AxxAxx/AxxSolder_hw/3rd-parties-libraries/3D-models/STL10N3LLH5.stp

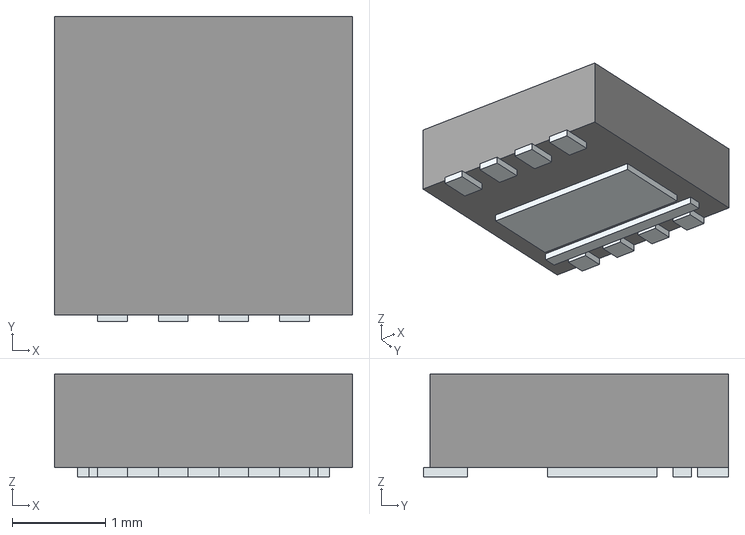
[picture p2: CAD file, 2023-12-22]
3rd-parties-libraries/3D-models/STL10N3LLH5.stp
3.20 x 3.27 x 1.10 mm
Pins
