AxxAxx/AxxSolder_hw/3rd-parties-libraries/3D-models/LM358BAIDR.stp

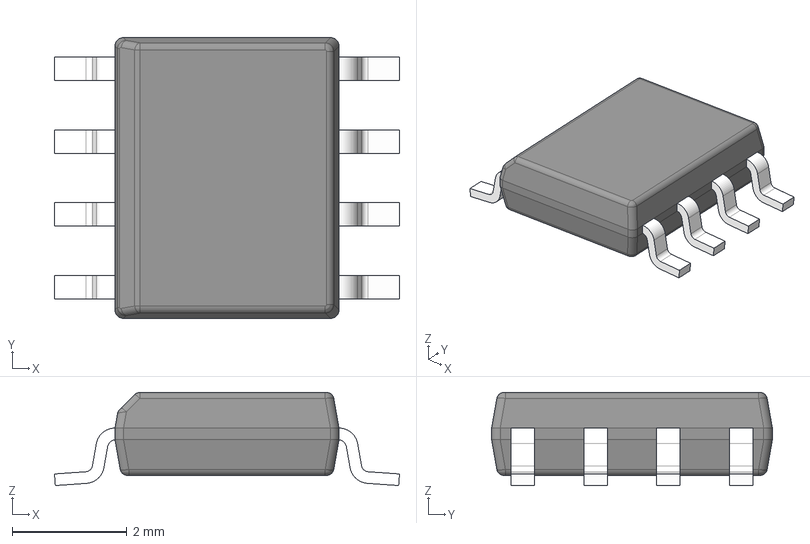
[picture p3: CAD file, 2023-12-22]
3rd-parties-libraries/3D-models/LM358BAIDR.stp
6.02 x 4.90 x 1.63 mm
BODY-SO
LEAD-D0008A x 8
