AxxAxx/AxxSolder_hw/3rd-parties-libraries/3D-models/PMEG10030ELPX.stp

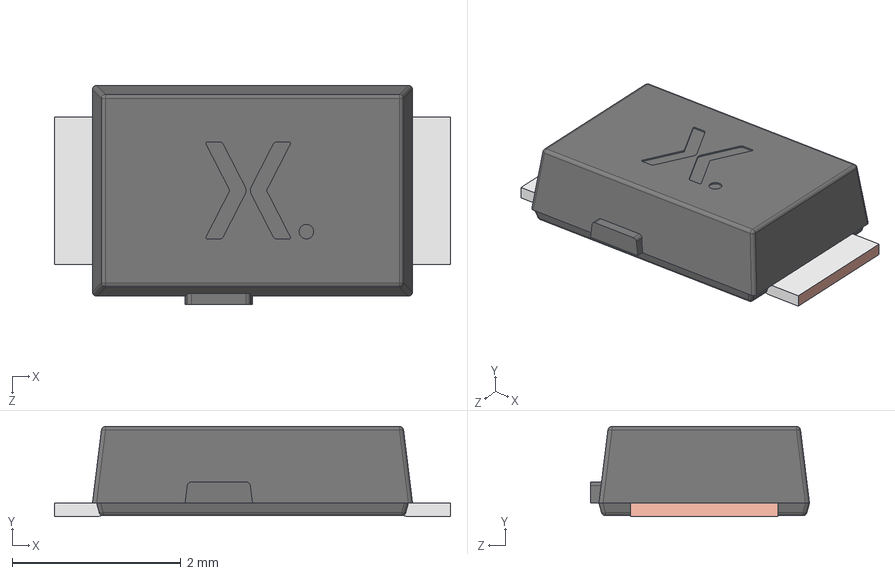
[picture p4: CAD file, 2023-12-22]
3rd-parties-libraries/3D-models/PMEG10030ELPX.stp
4.70 x 1.07 x 2.60 mm
SOD128 Lead
SOD128 Lower body
SOD128 Upper body
