AxxAxx/AxxSolder_hw/3rd-parties-libraries/3D-models/STM32G431KBT6.stp

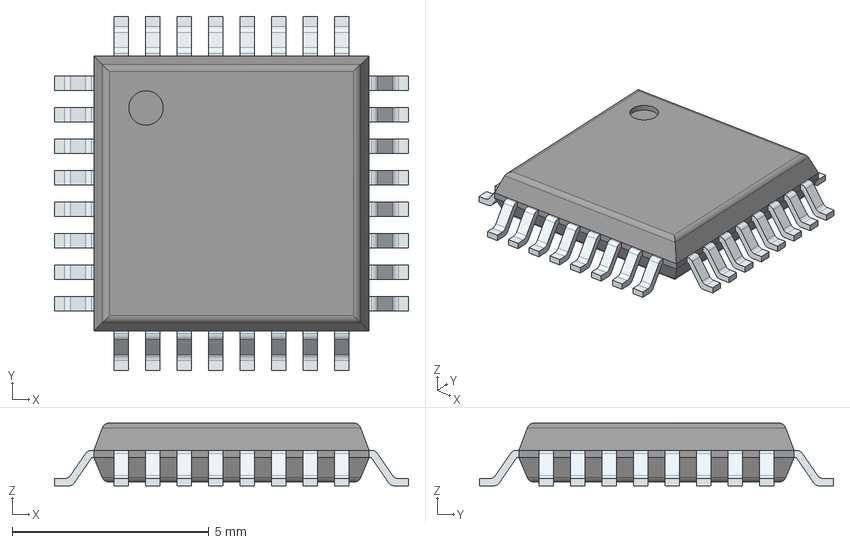
[picture p5: CAD file, 2023-12-22]
3rd-parties-libraries/3D-models/STM32G431KBT6.stp
9.00 x 9.00 x 1.60 mm
PinsArrayLR
PinsArrayTB
