AxxAxx/AxxSolder_hw/3rd-parties-libraries/3D-models/EMZR500ARA331MJA0G.stp

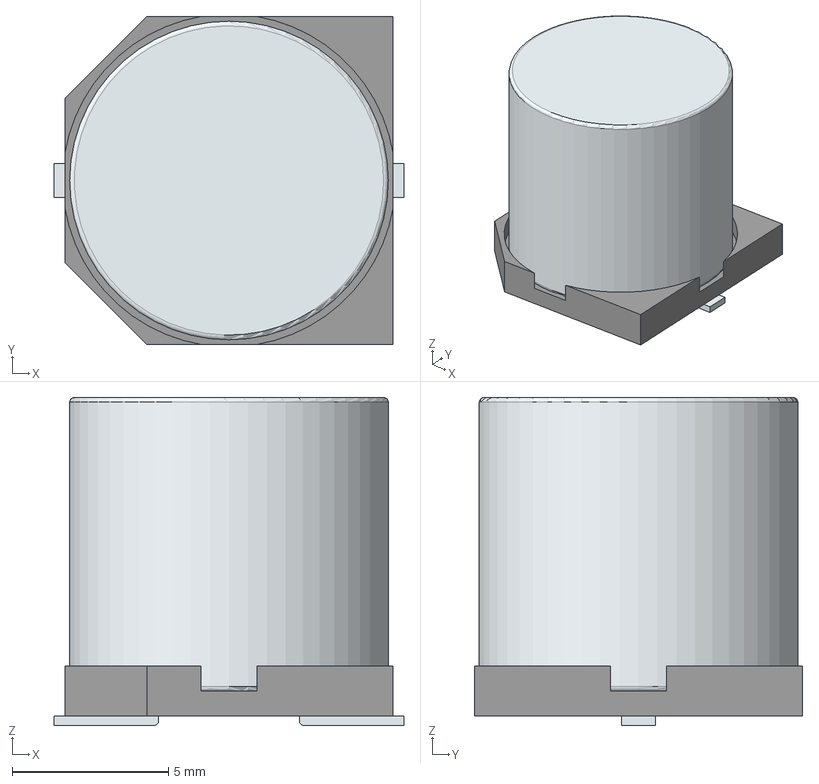
[picture p6: CAD file, 2023-12-22]
3rd-parties-libraries/3D-models/EMZR500ARA331MJA0G.stp
11.2 x 10.5 x 10.5 mm
Base
Pin1Fillet
Pin2Fillet
