AxxAxx/AxxSolder_hw/3rd-parties-libraries/3D-models/LD1117AS33TR.stp

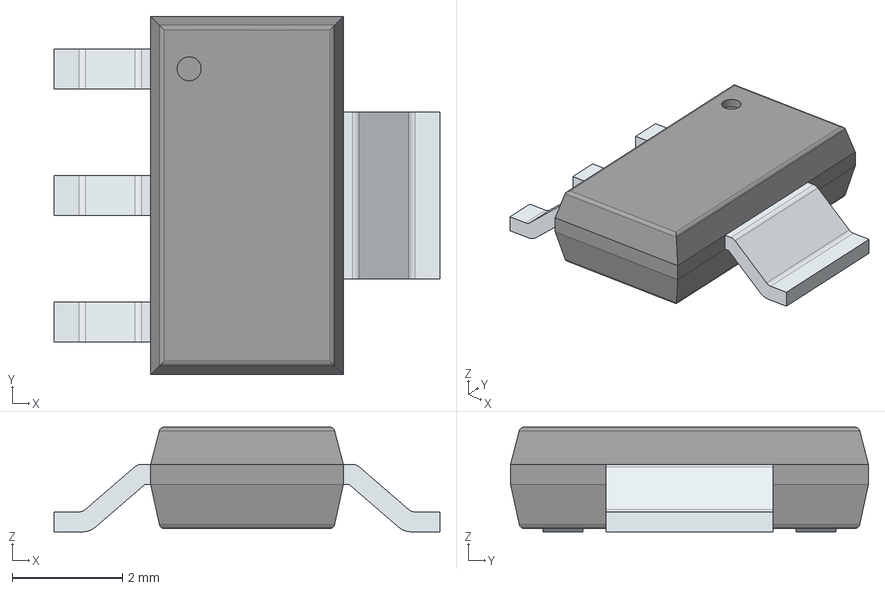
[picture p9: CAD file, 2023-12-22]
3rd-parties-libraries/3D-models/LD1117AS33TR.stp
7.00 x 6.50 x 1.90 mm
PinsArrayL
FilletPinR
