AxxAxx/AxxSolder_hw/3rd-parties-libraries/3D-models/CMI-9653S-SMT-TR.stp

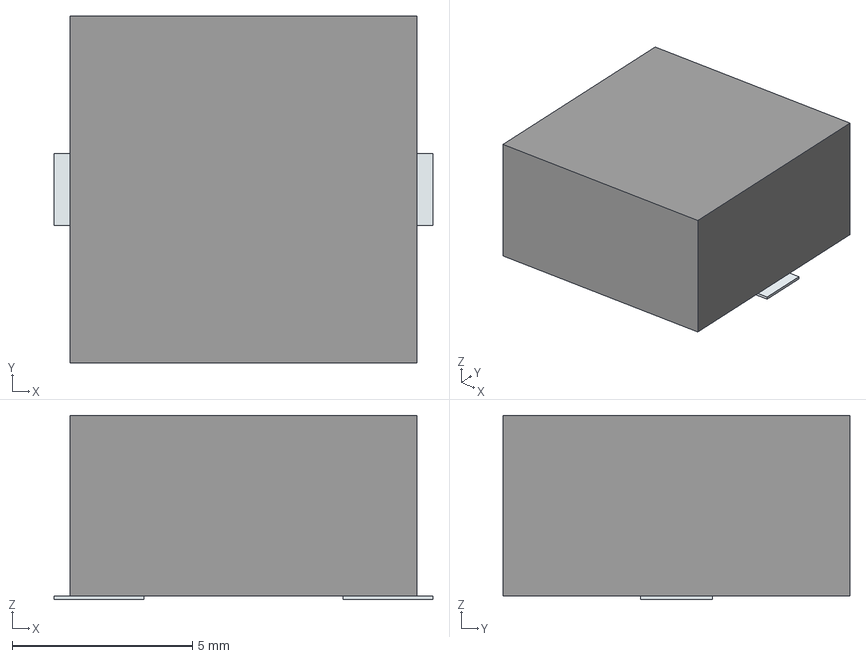
[picture p10: CAD file, 2023-12-22]
3rd-parties-libraries/3D-models/CMI-9653S-SMT-TR.stp
10.5 x 9.60 x 5.10 mm
Pins
