AxxAxx/AxxSolder_hw/3rd-parties-libraries/3D-models/STM32F303CCT6TR.stp

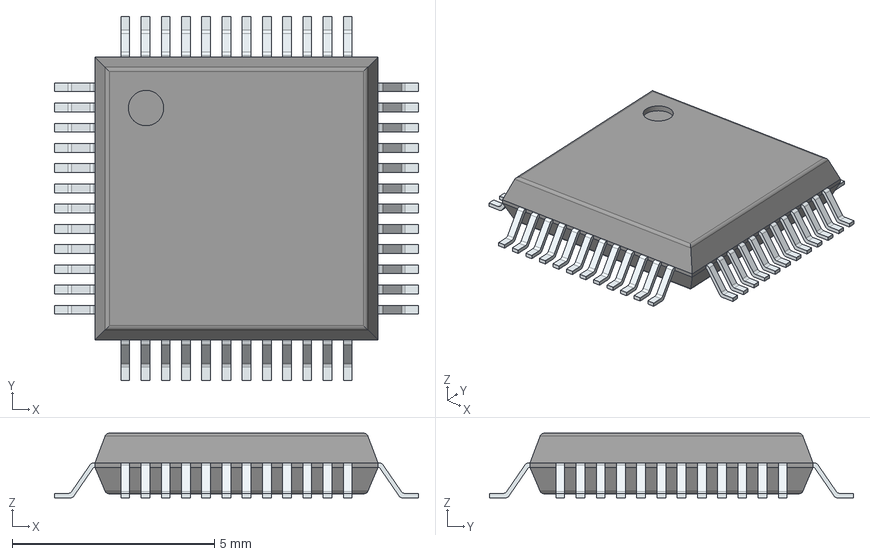
[picture p11: CAD file, 2023-12-22]
3rd-parties-libraries/3D-models/STM32F303CCT6TR.stp
9.00 x 9.00 x 1.60 mm
PinsArrayLR
PinsArrayTB
