AxxAxx/AxxSolder_hw/3rd-parties-libraries/3D-models/SRP7028CC-100M.stp

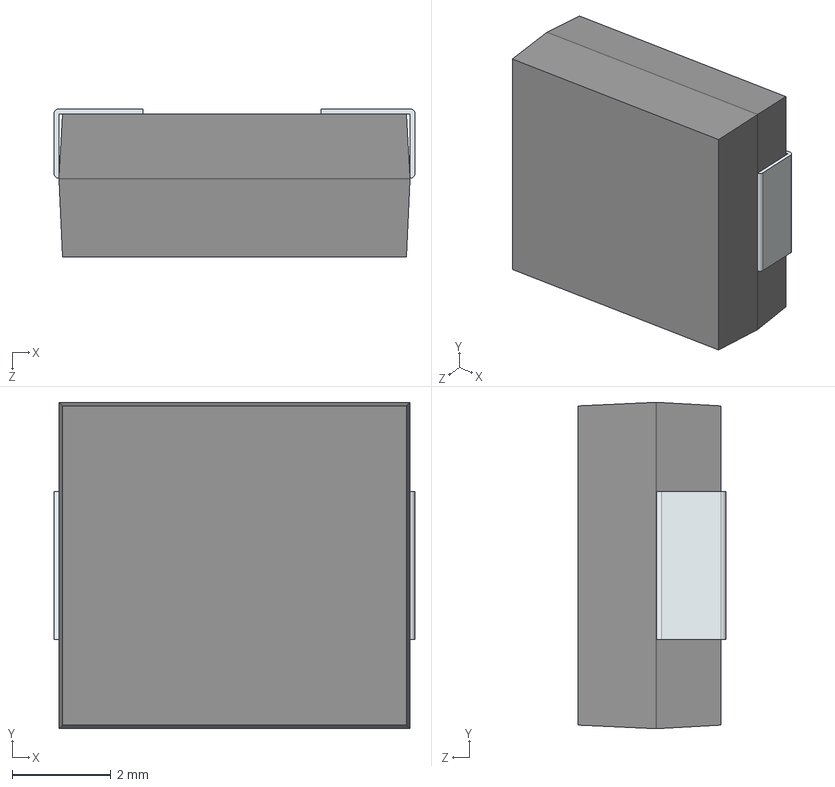
[picture p13: CAD file, 2023-12-22]
3rd-parties-libraries/3D-models/SRP7028CC-100M.stp
7.30 x 6.60 x 3.00 mm
Chamfer.stp
FilletPin1.stp
FilletPin2.stp
