AxxAxx/AxxSolder_hw/3rd-parties-libraries/3D-models/ADTSM6.STEP

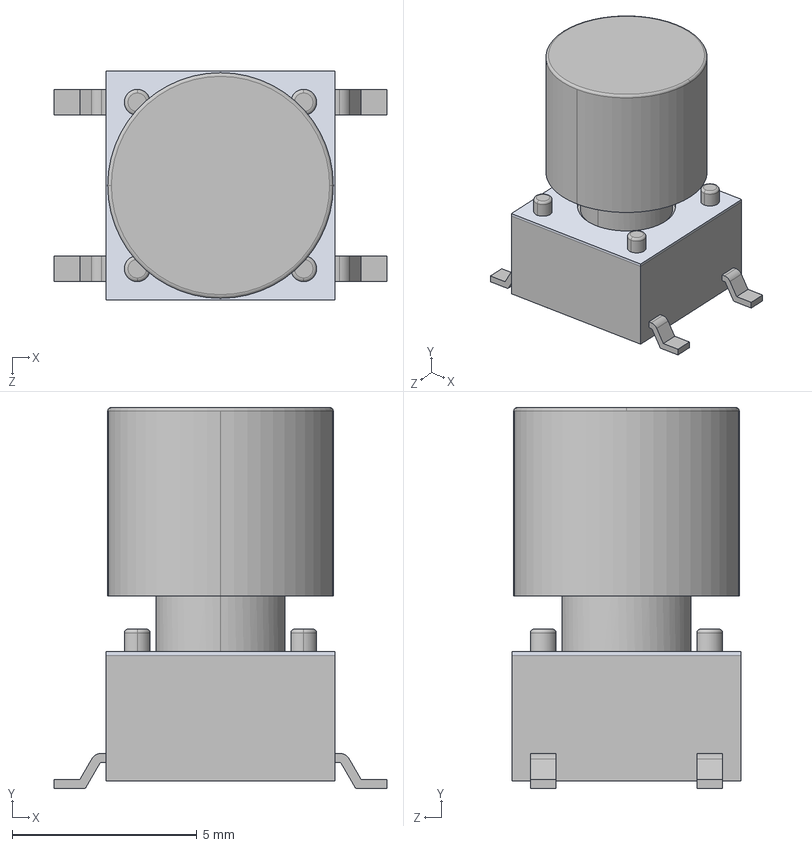
[picture p14: CAD file, 2023-12-22]
3rd-parties-libraries/3D-models/ADTSM6.STEP
9.00 x 10.3 x 6.20 mm
