AxxAxx/AxxSolder_hw/3rd-parties-libraries/3D-models/USB4110-GF-A.stp

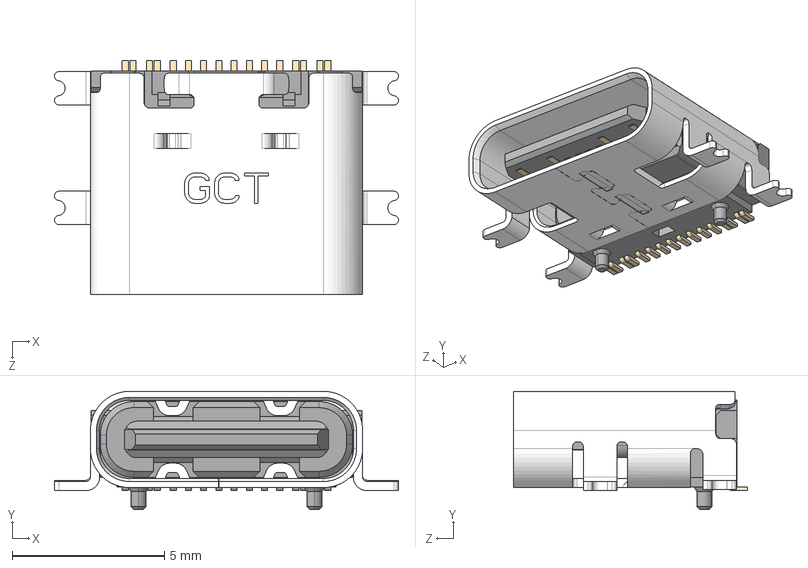
[picture p15: CAD file, 2023-12-22]
3rd-parties-libraries/3D-models/USB4110-GF-A.stp
11.3 x 3.89 x 7.70 mm
