AxxAxx/AxxSolder_hw/3rd-parties-libraries/3D-models/SMBJ24A.stp

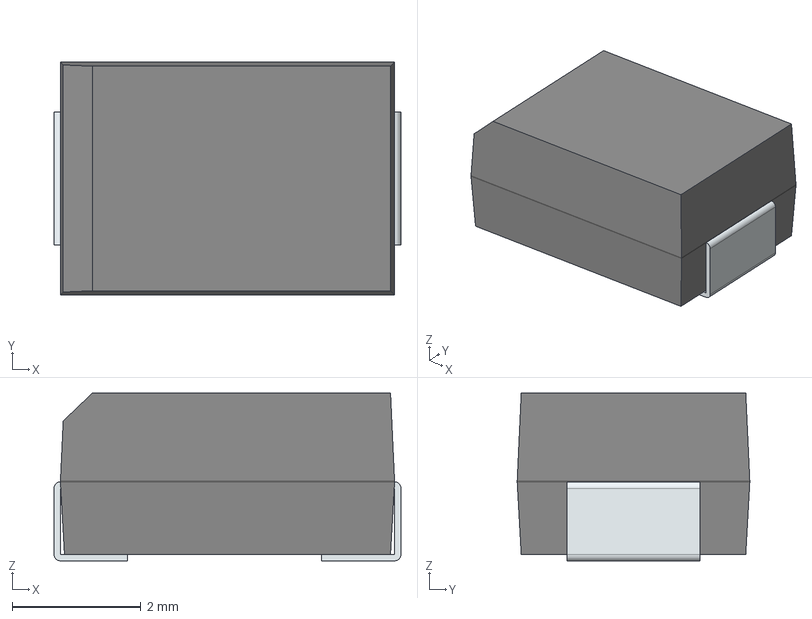
[picture p16: CAD file, 2023-12-07]
3rd-parties-libraries/3D-models/SMBJ24A.stp
5.40 x 3.62 x 2.61 mm
FilletPin1
FilletPin2
