AxxAxx/AxxSolder_hw/3rd-parties-libraries/3D-models/ESDA25P35-1U1M.stp

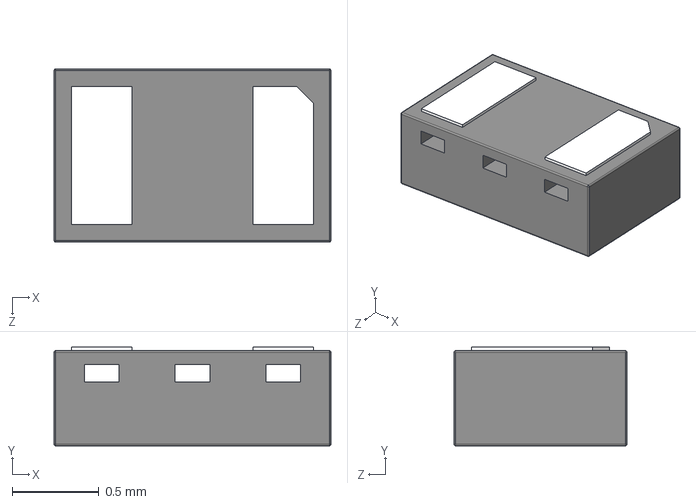
[picture p17: CAD file, 2023-12-07]
3rd-parties-libraries/3D-models/ESDA25P35-1U1M.stp
1.60 x 0.57 x 1.00 mm
