AxxAxx/AxxSolder_hw/3rd-parties-libraries/3D-models/LTC4440AHMS8E-5#PBF.stp

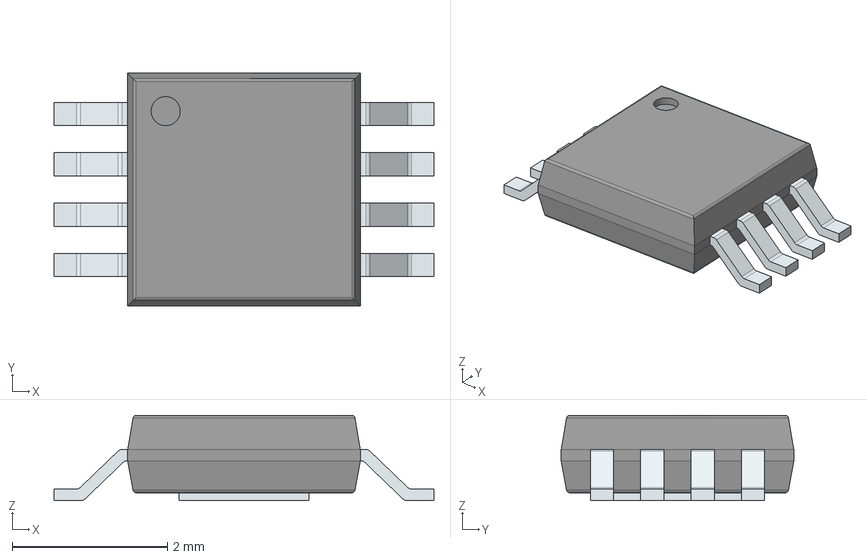
[picture p18: CAD file, 2023-12-07]
3rd-parties-libraries/3D-models/LTC4440AHMS8E-5#PBF.stp
4.90 x 3.00 x 1.10 mm
PinsArrayLR
ThermalPad
