AxxAxx/AxxSolder_hw/3rd-parties-libraries/3D-models/OPA2387DSGT.stp

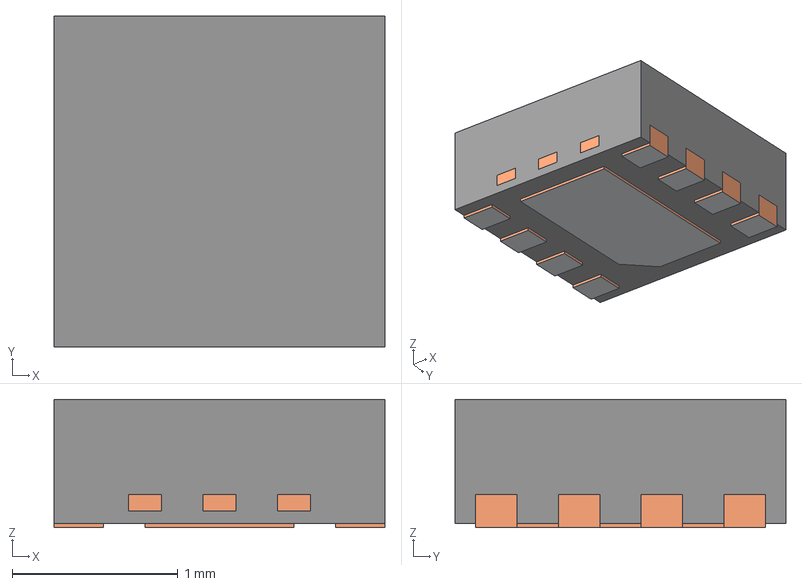
[picture p22: CAD file, 2023-12-07]
3rd-parties-libraries/3D-models/OPA2387DSGT.stp
2.00 x 2.00 x 0.775 mm
BODY-SON
FRAME-DSG0008A
PIN1-ID
