AxxAxx/AxxSolder_hw/3rd-parties-libraries/3D-models/STL9P3LLH6.stp

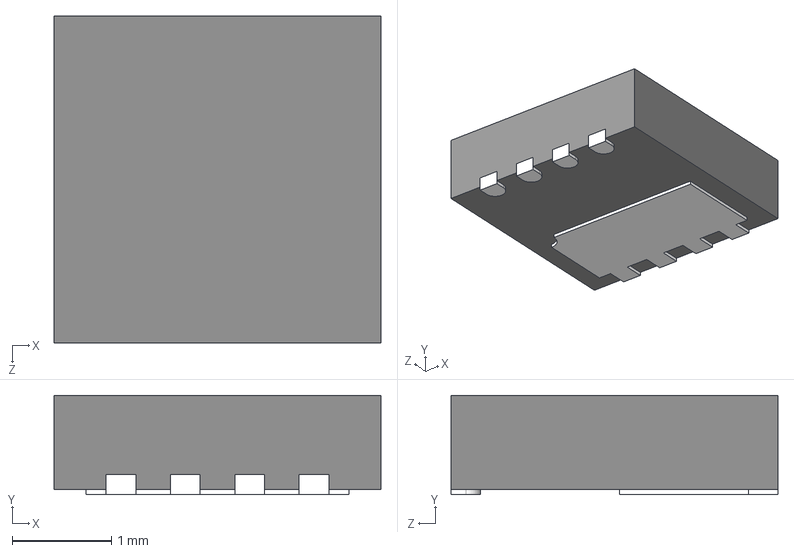
[picture p23: CAD file, 2023-12-07]
3rd-parties-libraries/3D-models/STL9P3LLH6.stp
3.30 x 1 x 3.30 mm
