AxxAxx/AxxSolder_hw/3rd-parties-libraries/3D-models/BLM18HE601SN1D.stp

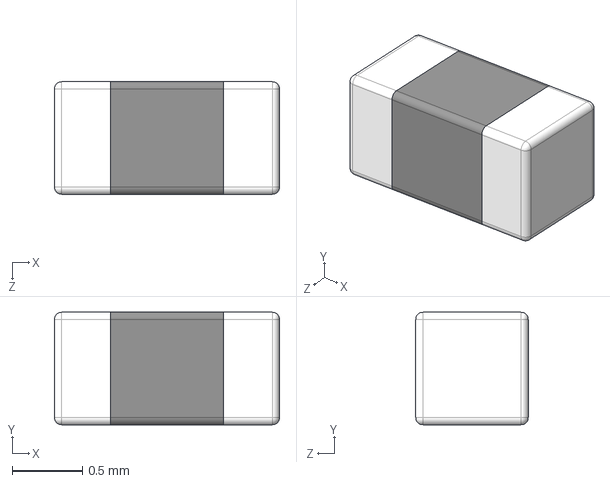
[picture p24: CAD file, 2023-12-07]
3rd-parties-libraries/3D-models/BLM18HE601SN1D.stp
1.60 x 0.8 x 0.8 mm
