AxxAxx/AxxSolder_hw/3rd-parties-libraries/3D-models/ESDA25W.stp

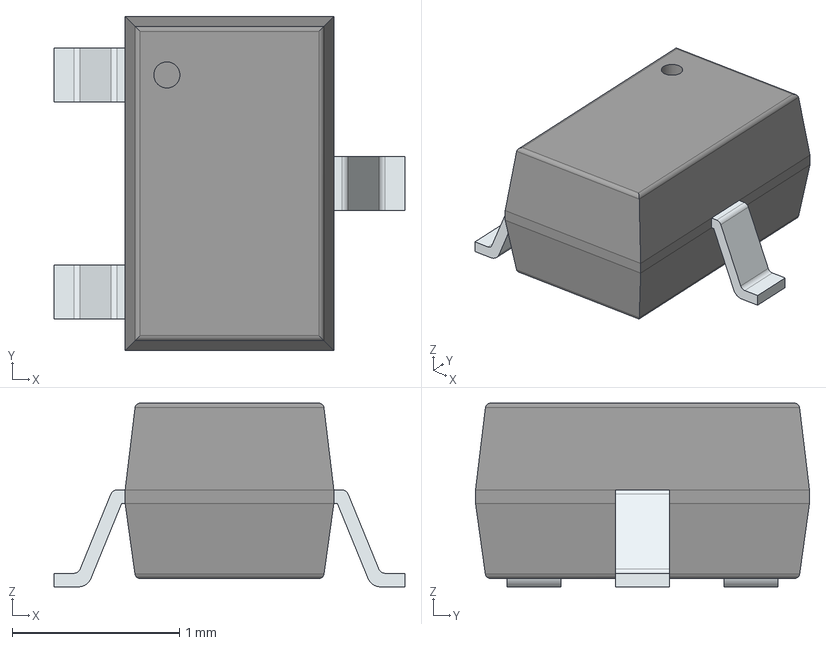
[picture p25: CAD file, 2023-12-07]
3rd-parties-libraries/3D-models/ESDA25W.stp
2.10 x 2.00 x 1.10 mm
PinsArrayL
FilletPinR
