AxxAxx/AxxSolder_hw/3rd-parties-libraries/3D-models/WSLP25125L000FEA.stp

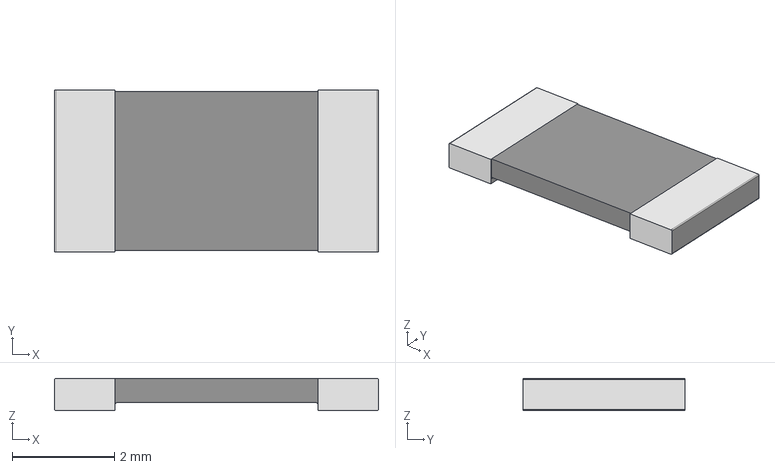
[picture p26: CAD file, 2023-12-07]
3rd-parties-libraries/3D-models/WSLP25125L000FEA.stp
6.35 x 3.18 x 0.635 mm
