AxxAxx/AxxSolder_hw/(list of files, cad)

Other CAD files:
3rd-parties-libraries/3D-models/0154007.DRTL.stp
3rd-parties-libraries/3D-models/691243110008.stp
3rd-parties-libraries/3D-models/691243110009.stp
3rd-parties-libraries/3D-models/ADTSM6.stp
3rd-parties-libraries/3D-models/LM74670QDGKRQ1.stp
3rd-parties-libraries/3D-models/MAX16171ATA_VY+T.stp
3rd-parties-libraries/3D-models/TPS54302DDCR.stp
