AxxAxx/AxxSolder_hw/AxxSolder.kicad_pcb

## KiCad design AxxSolder.kicad_pcb (2023-12-22)

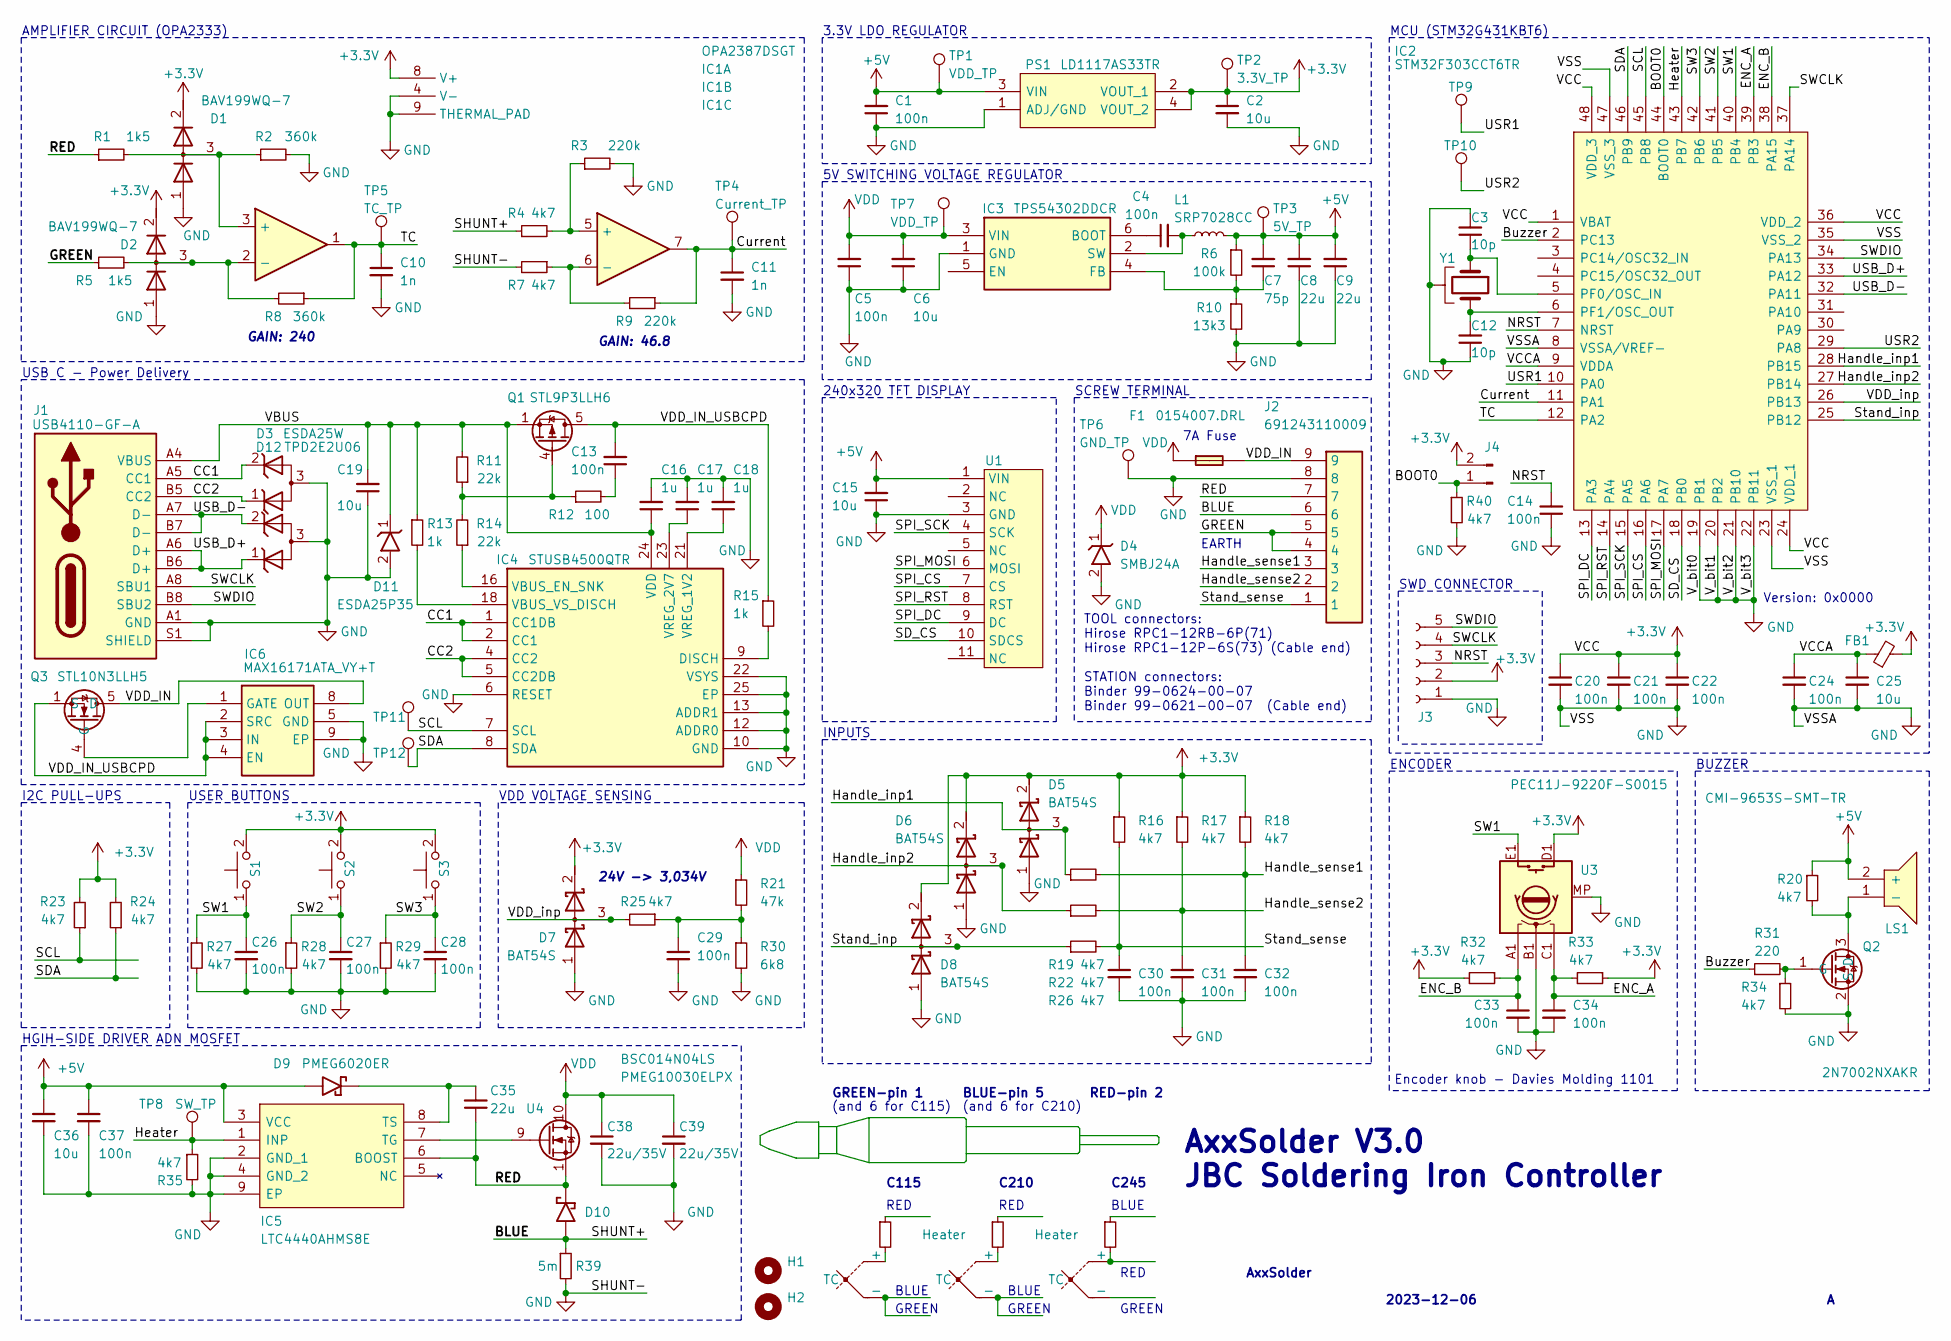
[picture p27: schematic AxxSolder.kicad_sch]

Parts:
C1, C4, C5, C13, C14, C20, C21, C22, C24, C26, C27, C28, C29, C30, C31, C32, C33, C34, C37: 100n; C_0603_1608Metric; Manufacturer_Part_Number GRM21BR72A104KAC4L
C2, C6, C15, C19, C25, C36: 10u; C_0603_1608Metric; Manufacturer_Part_Number GRM21BR6YA106ME43L
C3, C12: 10p; C_0603_1608Metric; Manufacturer_Part_Number GRM21A5C2E750FW01D
C7: 75p; C_0603_1608Metric; Manufacturer_Part_Number GRM21A5C2E750FW01D
C8, C9, C35: 22u; C_1206_3216Metric; Manufacturer_Part_Number C2012X6S1C226M125AC
C10, C11: 1n; C_0603_1608Metric; Manufacturer_Part_Number GRM2165C1H102JA01D
C16, C17, C18: 1u; C_0603_1608Metric; Manufacturer_Part_Number GRM21BC72A105KE01L
C38, C39: 22u/35V; C_1206_3216Metric; Manufacturer_Part_Number C3216X5R1V226M160AC
D1, D2: BAV199WQ-7; SOT65P210X110-3N; Mouser Part Number 621-BAV199WQ-7
D3: ESDA25W; SOT65P210X110-3N; Mouser Part Number 511-ESDA25W
D4: SMBJ24A; DIOM5436X261N; Mouser Part Number 576-SMBJ24A
D5, D6, D7, D8: BAT54S; SOT95P230X110-3N; Manufacturer_Part_Number BAT54S
D9: PMEG6020ER; PMEG6020ER115; Mouser Part Number 771-PMEG6020ER-115
D10: PMEG10030ELPX; SODFL4725X110N; Mouser Part Number 771-PMEG10030ELPX
D11: ESDA25P35; ESDA25P351U1M; Mouser Part Number 511-ESDA25P35-1U1M
D12: TPD2E2U06; SOT95P237X95-3N; Mouser Part Number 595-TPD2E2U06QDBZRQ1
F1: 0154007.DRL; 0154100DR; Mouser Part Number 576-0154007.DRL
FB1: BLM18HE601SN1D; R_0603_1608Metric; Mouser Part Number 81-BLM18HE601SN1D
H1, H2: MountingHole; MountingHole_2.5mm
IC1: OPA2387DSGT; SON50P200X200X80-9N; Mouser Part Number 595-OPA2387DSGT
IC2: STM32F303CCT6TR; QFP50P900X900X160-48N; Mouser Part Number 511-STM32F303CCT6TR
IC3: TPS54302DDCR; SOT95P280X110-6N; Mouser Part Number 595-TPS54302DDCR
IC4: STUSB4500QTR; QFN50P400X400X100-25N-D; Mouser Part Number 511-STUSB4500QTR
IC5: LTC4440AHMS8E; SOP65P490X110-9N; Mouser Part Number 584-C4440AHMS8E-5PBF
IC6: MAX16171ATA_VY+T; SON50P300X200X80-9N; Mouser Part Number 700-MAX16171ATA/VY+T
J1: USB4110-GF-A; USB4110GFA; Mouser Part Number 640-USB4110-GF-A
J2: 691243110009; Mouser Part Number 710-691243110009
J3: Conn_01x05_Socket; PinSocket_1x05_P2.54mm_Vertical
J4: Conn_01x02_Pin; PinHeader_1x02_P1.27mm_Vertical
L1: SRP7028CC; INDPM7366X300N; Mouser Part Number e
LS1: CMI-9653S-SMT-TR; CMI9653SSMTTR; Mouser Part Number 490-CMI-9653S-SMT-TR
PS1: LD1117AS33TR; SOT230P700X190-4N; Mouser Part Number 511-LD1117AS33
Q1: STL9P3LLH6; STL20N6F7; Mouser Part Number 511-STL9P3LLH6
Q2: 2N7002NXAKR; SOT95P230X110-3N; Manufacturer_Part_Number 2N7002NXAKR; Mouser Part Number 771-2N7002NXAKR
Q3: STL10N3LLH5; Mouser Part Number 511-STL10N3LLH5
R1, R5: 1k5; R_0603_1608Metric; Manufacturer_Part_Number ERJ-6ENF1501V
R2, R8: 360k; R_0603_1608Metric; Manufacturer_Part_Number ERJ-6ENF4703V
R3, R9: 220k; R_0603_1608Metric; Manufacturer_Part_Number ERJ-6ENF2203V
R4, R7, R19, R20, R22, R23, R24, R25, R26: 4k7; R_0603_1608Metric; Manufacturer_Part_Number ERJ-6ENF4701V
R6: 100k; R_0603_1608Metric; Manufacturer_Part_Number ERJ-6ENF1003V
R10: 13k3; R_0603_1608Metric; Manufacturer_Part_Number ERJ-6ENF1332V
R11, R14: 22k; R_0603_1608Metric; Manufacturer_Part_Number ERJ-6ENF2202V
R12: 100; R_0603_1608Metric; Manufacturer_Part_Number ERJ-6ENF1003V
R13: 1k; R_0603_1608Metric; Manufacturer_Part_Number ERJ-6ENF2202V
R15: 1k; R_0603_1608Metric; Manufacturer_Part_Number ERJ-6ENF1001V
R16, R17, R18, R27, R28, R29, R32, R33, R34, R35, R40: 4k7; R_0603_1608Metric; Manufacturer_Part_Number ERJ-6ENF1002V
R21: 47k; R_0603_1608Metric; Manufacturer_Part_Number ERJ-6ENF4702V
R30: 6k8; R_0603_1608Metric; Manufacturer_Part_Number ERJ-6ENF6801V
R31: 220; R_0603_1608Metric; Manufacturer_Part_Number ERJ-6ENF2200V
R36, R37: Heater
R38: Heater 2 OHM
R39: 5m; RESC6432X89N; Mouser Part Number 71-WSLP25125L000FEA
S1, S2, S3: ADTSM644KVTR; Mouser Part Number 642-ADTSM644KVTR
TC1, TC2, TC3: TC
TP1, TP7: VDD_TP; TestPoint_THTPad_D1.0mm_Drill0.5mm
TP2: 3.3V_TP; TestPoint_THTPad_D1.0mm_Drill0.5mm
TP3: 5V_TP; TestPoint_THTPad_D1.0mm_Drill0.5mm
TP4: Current_TP; TestPoint_Pad_D1.0mm
TP5: TC_TP; TestPoint_Pad_D1.0mm
TP6: GND_TP; TestPoint_THTPad_D1.0mm_Drill0.5mm
TP8: SW_TP; TestPoint_Pad_D1.0mm
TP9, TP10, TP11, TP12: DIAG_TP; TestPoint_Pad_D1.0mm
U1: Adafruit_240x320_TFT
U3: PEC11J-9220F-S0015; PEC11J9220FS0015; Mouser Part Number 652-PEC11J9220FS0015
U4: BSC014N04LS; Manufacturer_Part_Number BSC014N04LSATMA1
Y1: NX2016SA-32M-EXS00A-CS06465; NX2016SA32MEXS00ACS06465; Mouser Part Number 344-NX2016SA32S06465

Connections:
+3.3V: C2.1, C20.1, C21.1, C22.1, D1.2, D2.2, D5.2 (K), D6.2 (K), D7.2 (K), D8.2 (K), FB1.2, IC1.8 (V+), IC2.1 (VBAT), IC2.24 (VDD_1), IC2.36 (VDD_2), IC2.48 (VDD_3), J3.2, J4.2, PS1.2 (VOUT_1), PS1.4 (VOUT_2), R16.1, R17.1, R18.1, R23.2, R24.2, R32.2, R33.1, S1.2, S2.2, S3.2, TP2.1, U3.D1
+5V: C1.2, C7.2, C8.2, C9.2, C15.2, C36.1, C37.1, D9.2, IC5.3 (VCC), L1.2, LS1.2 (+), PS1.3 (VIN), R6.1, R20.1, TP1.1, TP3.1, U1.1 (VIN)
/BLUE: D10.2, J2.6, R4.1, R39.1
/BOOT0: IC2.44 (BOOT0), J4.1, R40.1
/Buzzer: IC2.2 (PC13), R31.1
/CC1: D3.2, IC4.1 (CC1DB), IC4.2 (CC1), J1.A5 (CC1)
/CC2: D3.1, IC4.4 (CC2), IC4.5 (CC2DB), J1.B5 (CC2)
/Current: C11.1, IC1.7, IC2.11 (PA1), R9.1, TP4.1
/ENC_A: C34.1, IC2.39 (PB3), R33.2, U3.C1
/ENC_B: C33.1, IC2.38 (PA15), R32.1, U3.A1
/GREEN: J2.4, J2.5, R5.1
/Handle_inp1: D5.3 (common), IC2.28 (PB15), R19.1
/Handle_inp2: D6.3 (common), IC2.27 (PB14), R22.1
/Handle_sense1: C32.1, J2.3, R18.2, R19.2
/Handle_sense2: C31.1, J2.2, R17.2, R22.2
/Heater: IC2.43 (PB7), IC5.1 (INP), R35.1, TP8.1
/NRST: C14.2, IC2.7 (NRST), J3.3
/RED: C35.1, D10.1, IC5.6 (BOOST), J2.7, R1.1, U4.1 (S)
/SCL: IC2.45 (PB8), IC4.7 (SCL), R23.1, TP11.1
/SDA: IC2.46 (PB9), IC4.8 (SDA), R24.1, TP12.1
/SD_CS: IC2.18 (PB0), U1.10 (SDCS)
/SPI_CS: IC2.16 (PA6), U1.7 (CS)
/SPI_DC: IC2.13 (PA3), U1.9 (DC)
/SPI_MOSI: IC2.17 (PA7), U1.6 (MOSI)
/SPI_RST: IC2.14 (PA4), U1.8 (RST)
/SPI_SCK: IC2.15 (PA5), U1.4 (SCK)
/SW1: C26.1, IC2.40 (PB4), R27.1, S1.1, U3.E1
/SW2: C27.1, IC2.41 (PB5), R28.1, S2.1
/SW3: C28.1, IC2.42 (PB6), R29.1, S3.1
/SWCLK: IC2.37 (PA14), J1.A8 (SBU1), J3.4
/SWDIO: IC2.34 (PA13), J1.B8 (SBU2), J3.5
/Stand_inp: D8.3 (common), IC2.25 (PB12), R26.1
/Stand_sense: C30.1, J2.1, R16.2, R26.2
/TC: C10.1, IC1.1, IC2.12 (PA2), R8.1, TP5.1
/USB_D+: D12.1, IC2.33 (PA12), J1.A6 (D+), J1.B6 (D+)
/USB_D-: D12.2, IC2.32 (PA11), J1.A7 (D-), J1.B7 (D-)
/USR1: IC2.10 (PA0), TP9.1
/USR2: IC2.29 (PA8), TP10.1
/VBUS: C16.1, C19.2, D11.1 (K), IC4.24 (VDD), J1.A4 (VBUS), J1.A9 (VBUS), J1.B4 (VBUS), J1.B9 (VBUS), Q1.1 (S), R11.2, R13.1
/VCCA: C24.1, C25.1, FB1.1, IC2.9 (VDDA)
/VDD_IN: F1.2, IC6.8 (OUT), J2.9, Q3.5 (D)
/VDD_IN_USBCPD: C13.2, IC6.2 (SRC), IC6.3 (IN), IC6.4 (EN), Q1.5 (D), Q3.1 (S), R15.1
/VDD_inp: D7.3 (common), IC2.26 (PB13), R25.2
GND: C1.1, C2.2, C3.2, C5.1, C6.1, C8.1, C9.1, C10.2, C11.2, C12.1, C14.1, C15.1, C16.2, C17.2, C18.2, C19.1, C20.2, C21.2, C22.2, C24.2, C25.2, C26.2, C27.2, C28.2, C29.2, C30.2, C31.2, C32.2, C33.2, C34.2, C36.2, C37.2, C38.2, C39.2, D1.1, D2.1, D3.3, D4.2 (A), D5.1 (A), D6.1 (A), D7.1 (A), D8.1 (A), D11.2 (A), D12.3, IC1.4 (V-), IC1.9 (THERMAL_PAD), IC2.8 (VSSA/VREF-), IC2.19 (PB1), IC2.20 (PB2), IC2.21 (PB10), IC2.22 (PB11), IC2.23 (VSS_1), IC2.35 (VSS_2), IC2.47 (VSS_3), IC3.1 (GND), IC4.6 (RESET), IC4.10 (GND), IC4.12 (ADDR0), IC4.13 (ADDR1), IC4.22 (VSYS), IC4.25 (EP), IC5.2 (GND_1), IC5.4 (GND_2), IC5.9 (EP), IC6.5 (GND), IC6.9 (EP), J1.A1 (GND), J1.A12 (GND), J1.B1 (GND), J1.B12 (GND), J1.S1 (SHIELD), J2.8, J3.1, PS1.1 (ADJ/GND), Q2.2 (S), R2.2, R3.2, R7.2, R10.2, R27.2, R28.2, R29.2, R30.2, R34.2, R35.2, R39.2, R40.2, TP6.1, U1.3 (GND), U3.B1, U3.MP, Y1.2
unnamed: C13.1, R12.2
unnamed: C29.1, R21.2, R25.1, R30.1
unnamed: D1.3, IC1.3 (+), R1.2, R2.1
unnamed: D2.3, IC1.2 (-), R5.2, R8.2
unnamed: IC1.5 (+), R3.1, R4.2
unnamed: IC1.6 (-), R7.1, R9.2
unnamed: C3.1, IC2.5 (PF0/OSC_IN), Y1.1
unnamed: C12.2, IC2.6 (PF1/OSC_OUT), Y1.3
unnamed: C4.1, IC3.6 (BOOT)
unnamed: C7.1, IC3.4 (FB), R6.2, R10.1
unnamed: C4.2, IC3.2 (SW), L1.1
unnamed: IC4.9 (DISCH), R15.2
unnamed: IC4.16 (VBUS_EN_SNK), R14.1
unnamed: IC4.18 (VBUS_VS_DISCH), R13.2
unnamed: C18.1, IC4.21 (VREG_1V2)
unnamed: C17.1, IC4.23 (VREG_2V7)
unnamed: IC5.7 (TG), U4.9 (G)
unnamed: C35.2, D9.1, IC5.8 (TS)
unnamed: IC6.1 (GATE), Q3.4 (G)
unnamed: LS1.1 (-), Q2.3 (D), R20.2
unnamed: Q1.4 (G), R11.1, R12.1, R14.2
unnamed: Q2.1 (G), R31.2, R34.1
unnamed: R36.2, TC1.1 (+)
unnamed: R37.2, TC2.1 (+)
unnamed: R38.2, TC3.1 (+)
VDD: C5.2, C6.2, C38.1, C39.1, D4.1 (K), F1.1, IC3.3 (VIN), R21.1, TP7.1, U4.10 (D)

Notes on the sheet:
Version: 0x0000
USER BUTTONS
C115
7A Fuse
Encoder knob - Davies Molding 1101
USB C - Power Delivery
MCU (STM32G431KBT6)
EARTH
GREEN
GREEN-pin 1
RED
(and 6 for C210)
SCREW TERMINAL
AMPLIFIER CIRCUIT (OPA2333)
24V -> 3,034V
VDD VOLTAGE SENSING
C245
ENCODER
SWD CONNECTOR
BLUE
BLUE-pin 5
2023-12-06
BUZZER
5V SWITCHING VOLTAGE REGULATOR
AxxSolder V3.0 JBC Soldering Iron Controller
TOOL connectors: Hirose RPC1-12RB-6P(71) Hirose RPC1-12P-6S(73) (Cable end) STATION connectors: Binder 99-0624-00-07 Binder 99-0621-00-07 (Cable end)
C210
INPUTS
HGIH-SIDE DRIVER ADN MOSFET
AxxSolder
RED-pin 2
RED
I2C PULL-UPS
GAIN: 240
GAIN: 46.8
3.3V LDO REGULATOR
(and 6 for C115)
240x320 TFT DISPLAY

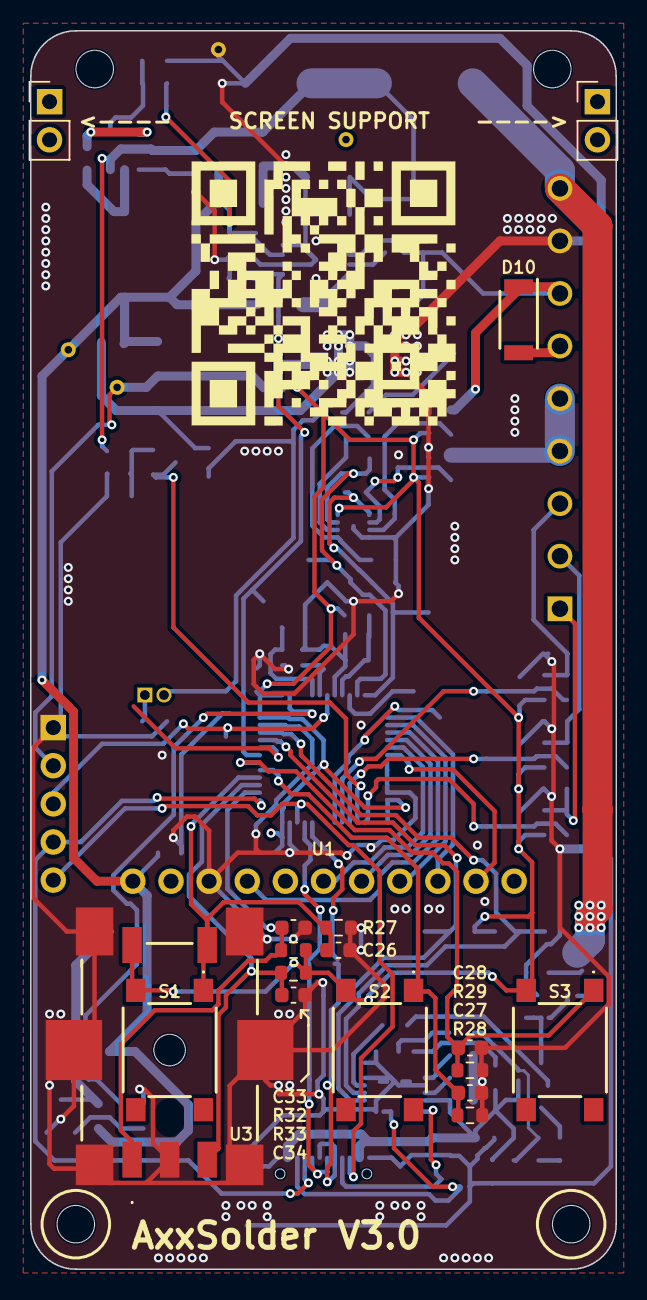
[picture p28: board AxxSolder.kicad_pcb from above]

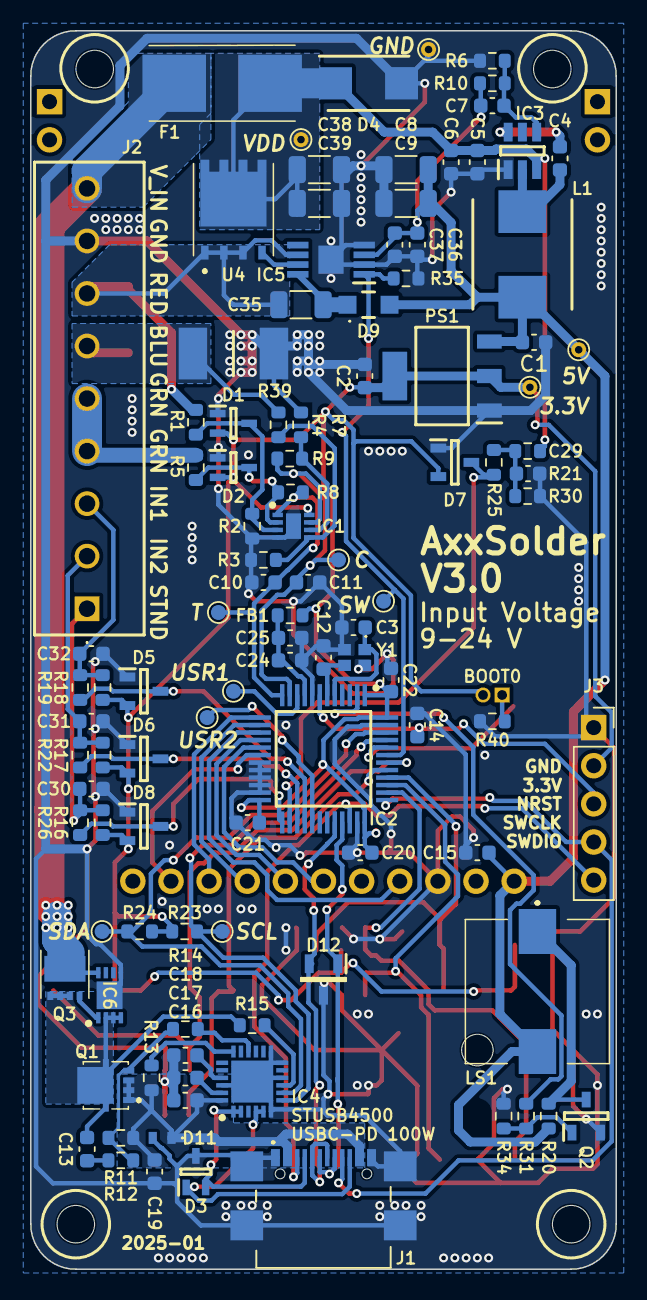
[picture p29: board AxxSolder.kicad_pcb from below]

Board: 2 copper layers, 39.0 x 82.5 mm, 125 parts (107 on the bottom side), 67 nets.
