AxxAxx/AxxSolder_hw/(commit log)

2023-12-07 update filestructure for AxxSolder V3.0 and forward
    [2N7002NXAKR.stp, 691243110008.stp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]
2023-12-22 multiple updates for AxxSolder hw 3.0
    [0154007.DRTL.stp, 691243110009.stp, ADTSM6.STEP, ADTSM6.stp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]
2023-12-23 update BOM
    [AxxSolder.kicad_sch]
